TheCacophonyProject/battery-dc-dc-converter/README.md

# battery-dc-dc-converter
Designed to step down the voltage from a scooter battery to 12V
