TheCacophonyProject/battery-dc-dc-converter/battery-dc-dc/battery-dc-dc.kicad_pcb

## KiCad design battery-dc-dc/battery-dc-dc.kicad_pcb (2024-11-13)

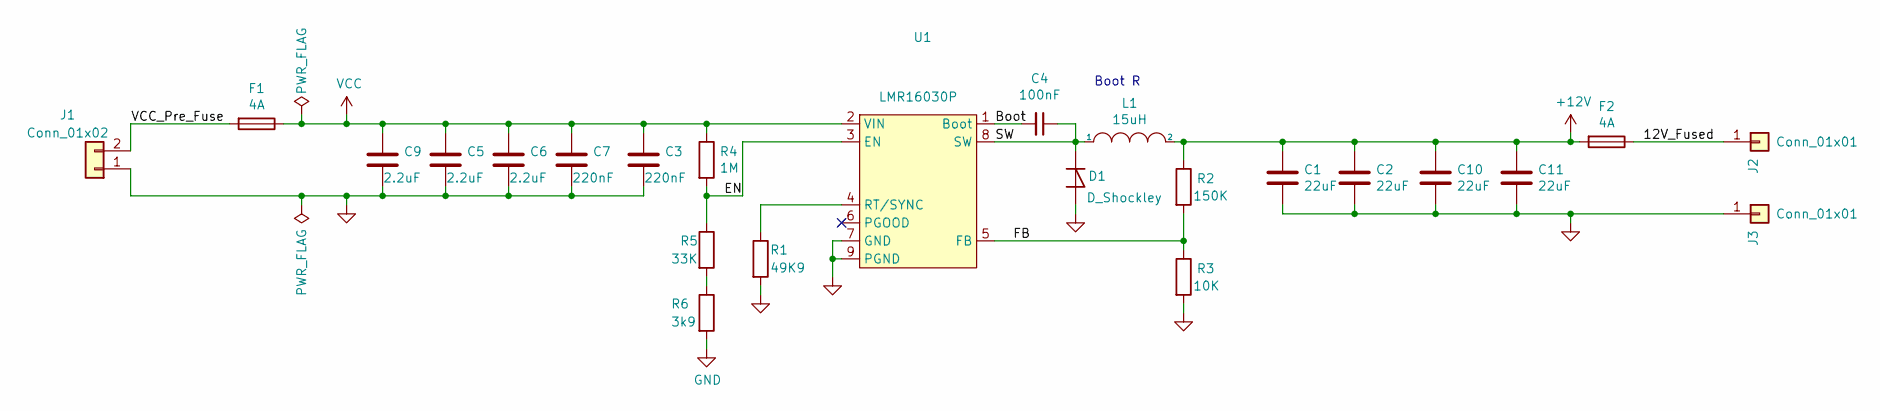
[picture p1: schematic battery-dc-dc.kicad_sch]

Parts:
C1, C2, C10, C11: 22uF; C_0805_2012Metric; LCSC C602037
C3, C7: 220nF; C_0805_2012Metric; LCSC C513710
C4: 100nF; C_0603_1608Metric; LCSC C14663
C5, C6, C9: 2.2uF; C_1210_3225Metric; LCSC C55151
D1: D_Shockley; D_SMA; LCSC C22452
F1, F2: 4A; Fuse_1206_3216Metric_Pad1.42x1.75mm_HandSolder; LCSC C136349
J1: Conn_01x02; xt60pw-m; LCSC C98732
J2, J3: Conn_01x01; hole-pad
L1: 15uH; SWRH1207B; LCSC C115137
R1: 49K9; R_0603_1608Metric; LCSC C23184
R2: 150K; R_0603_1608Metric; LCSC C326734
R3: 10K; R_0603_1608Metric; LCSC C25804
R4: 1M; R_0603_1608Metric; LCSC C22935
R5: 33K; R_0603_1608Metric; LCSC C4216
R6: 3k9; R_0603_1608Metric; LCSC C23018
U1: LMR16030P; TI_SO-PowerPAD-8; LCSC C90665

Connections:
+12V: C1.1, C2.1, C10.1, C11.1, F2.2, L1.2, R2.1
/12V_Fused: F2.1, J2.1
/Boot: C4.2, U1.1 (Boot)
/EN: R4.2, R5.1, U1.3 (EN)
/FB: R2.2, R3.1, U1.5 (FB)
/SW: C4.1, D1.1 (K), L1.1, U1.8 (SW)
/VCC_Pre_Fuse: F1.2, J1.2
GND: C1.2, C2.2, C3.2, C5.2, C6.2, C7.2, C9.2, C10.2, C11.2, D1.2 (A), J1.1, J3.1, R1.2, R3.2, R6.2, U1.7 (GND), U1.9 (PGND)
unnamed: R5.2, R6.1
unnamed: R1.1, U1.4 (RT/SYNC)
VCC: C3.1, C5.1, C6.1, C7.1, C9.1, F1.1, R4.1, U1.2 (VIN)

Notes on the sheet:
Boot R

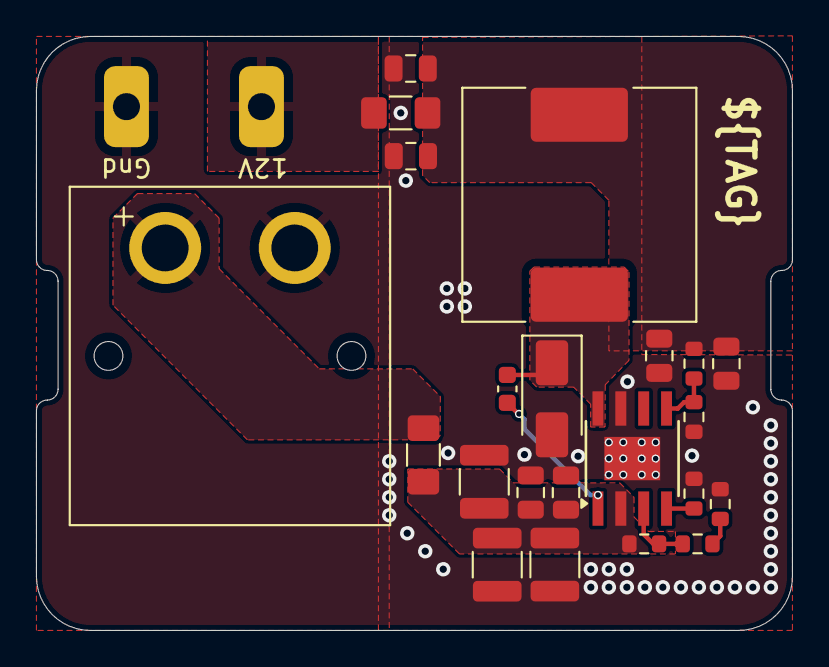
[picture p2: board battery-dc-dc.kicad_pcb from above]

Board: 4 copper layers, 42.0 x 33.0 mm, 24 parts (0 on the bottom side), 11 nets.
