TheCacophonyProject/battery-dc-dc-converter/(commit log)

2020-09-11 version 0.1
    [battery-dc-dc-converter.kicad_pcb, battery-dc-dc-converter.sch]
2020-09-11 Small tidyup of filled zones
    [battery-dc-dc-converter.kicad_pcb]
2020-11-16 Added fuses
    [battery-dc-dc-converter.kicad_pcb, battery-dc-dc-converter.sch]
2020-11-19 Added low voltage protection
    [battery-dc-dc-converter.kicad_pcb, battery-dc-dc-converter.sch, under-voltage-lockout-calculation.ods]
2020-11-22 Added panelized layout
    [battery-dc-dc-converter-panelized.kicad_pcb, battery-dc-dc-converter.kicad_pcb, battery-dc-dc-converter.sch]
2021-02-24 Updateed power pads, on/off resistors.
    [battery-dc-dc-converter.kicad_pcb, battery-dc-dc-converter.sch, battery-dc-dc-converter.step, under-voltage-lockout-calculation.ods]
2021-03-16 Panalized PCBs
    [battery-dc-dc-converter-panelized.kicad_pcb, battery-dc-dc-converter.kicad_pcb, battery-dc-dc-converter.sch]
2021-03-16 Added recessed nibbles
    [battery-dc-dc-converter-panelized.kicad_pcb, battery-dc-dc-converter.kicad_pcb]
2021-10-10 Improved EMI
    [battery-dc-dc-converter.kicad_pcb, battery-dc-dc-converter.sch]
2021-10-10 Added lmr16020
    [battery-dc-dc-converter.kicad_pcb, battery-dc-dc-converter.sch]
2021-10-10 Added dc-dc v0.2 text
    [battery-dc-dc-converter.kicad_pcb]
2021-10-11 Order v0.2
    [battery-dc-dc-converter.kicad_pcb, battery-dc-dc-converter.sch]
2021-11-08 Put power plug on same side
    [battery-dc-dc-converter.kicad_pcb, battery-dc-dc-converter.sch]
2024-11-13 panelize WIP
    [battery-dc-dc-converter.kicad_pcb, battery-dc-dc-converter.kicad_sch]
2024-11-13 Tidy up
    [battery-dc-dc-converter-panelized.kicad_pcb, battery-dc-dc-converter.kicad_pcb, battery-dc-dc-converter.kicad_sch, battery-dc-dc-converter.sch, battery-dc-dc-converter.step]
2024-11-13 0.4.0 release
    [battery-dc-dc.kicad_pcb, battery-dc-dc.kicad_sch]
